Drazuam/microquad/hw/quad_v0/pcb_pdf/minidrone-B_Cu.pdf

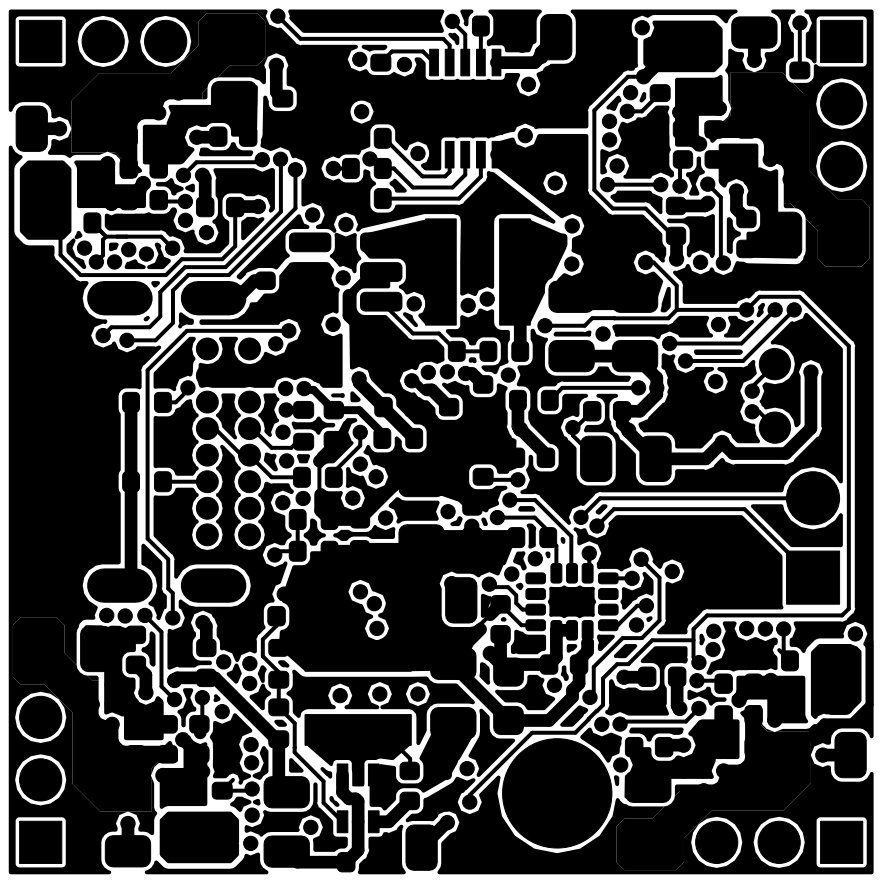
[picture p6: page 1]
