Drazuam/microquad/hw/quad_v0/pcb_pdf/minidrone-B_Mask.pdf

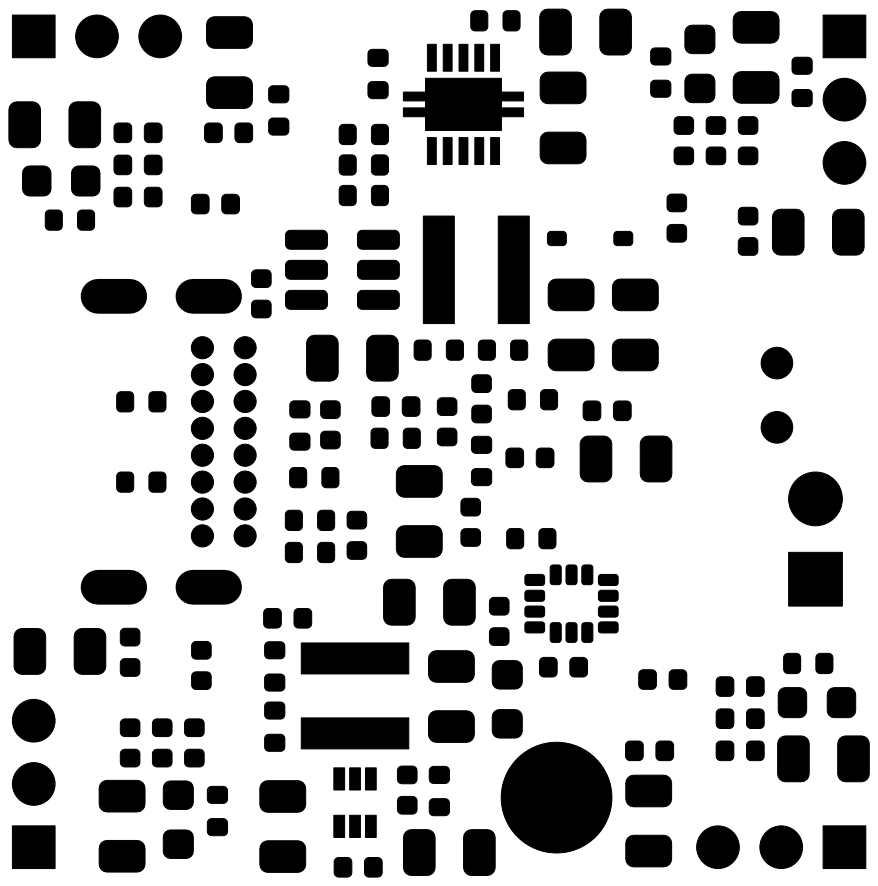
[picture p7: page 1]
