Drazuam/microquad/hw/quad_v0/pcb_pdf/minidrone-B_Paste.pdf

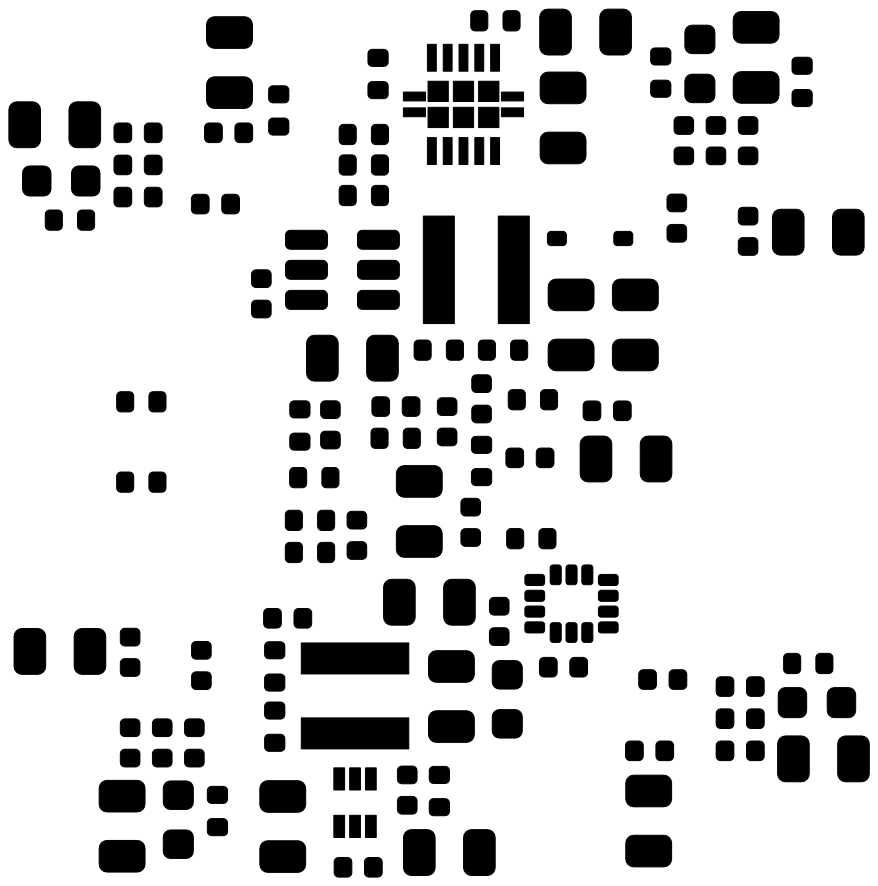
[picture p8: page 1]
