Drazuam/microquad/hw/quad_v0/pcb_pdf/minidrone-B_Silkscreen.pdf

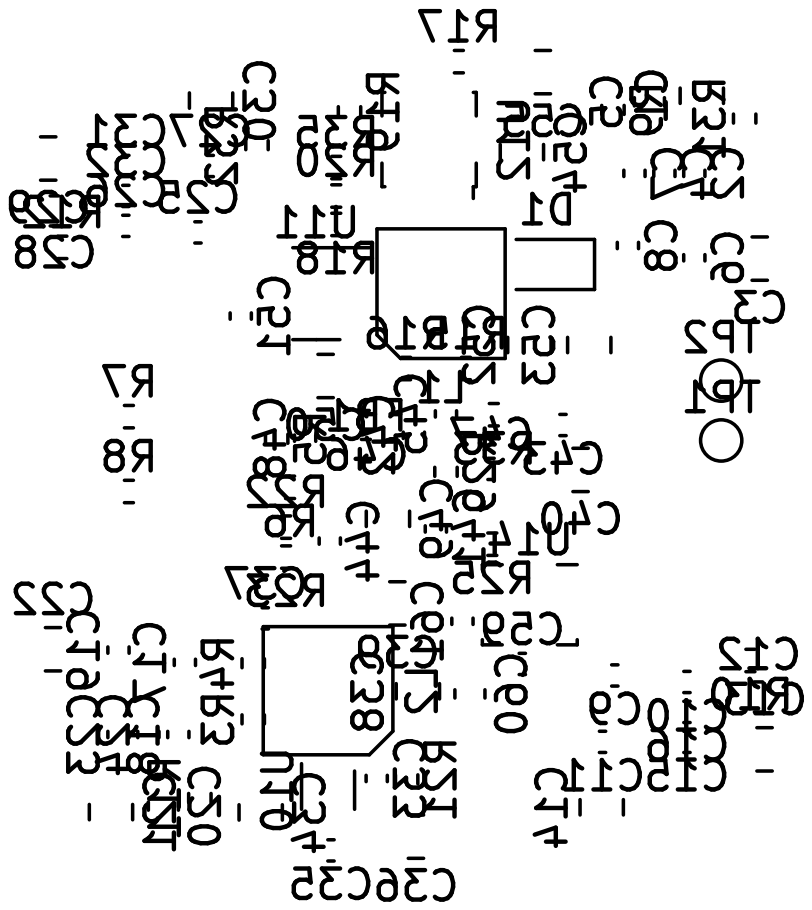
[picture p9: page 1]
