Drazuam/microquad/hw/quad_v0/pcb_pdf/minidrone-F_Cu.pdf

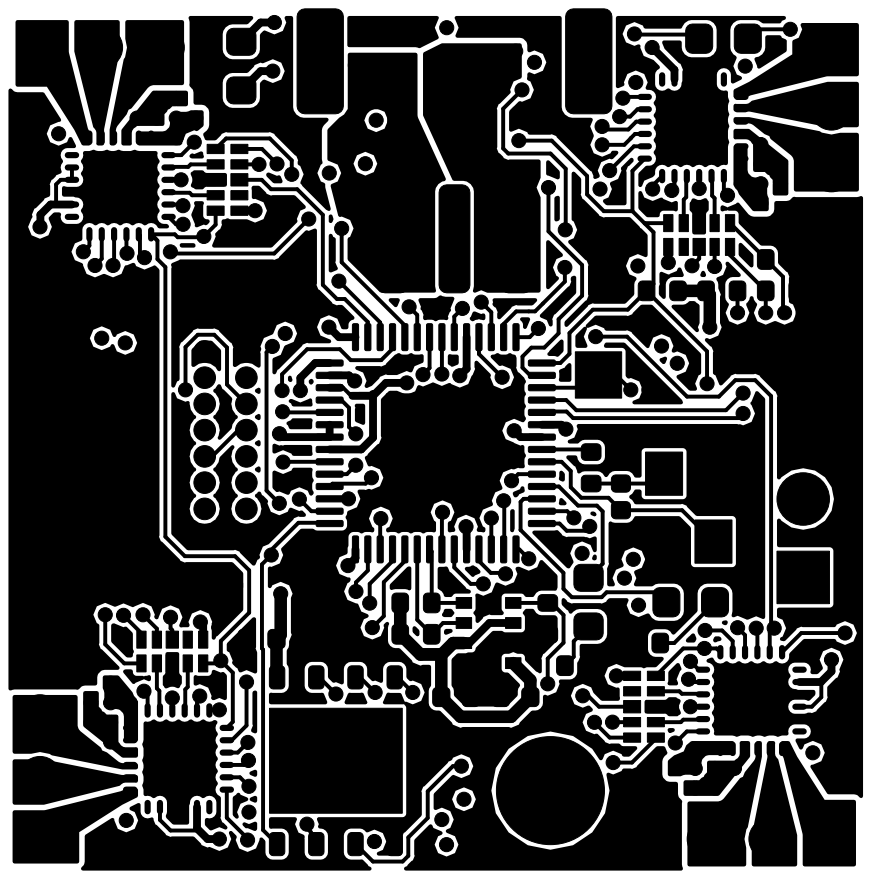
[picture p10: page 1]
