Drazuam/microquad/hw/quad_v0/pcb_pdf/minidrone-F_Mask.pdf

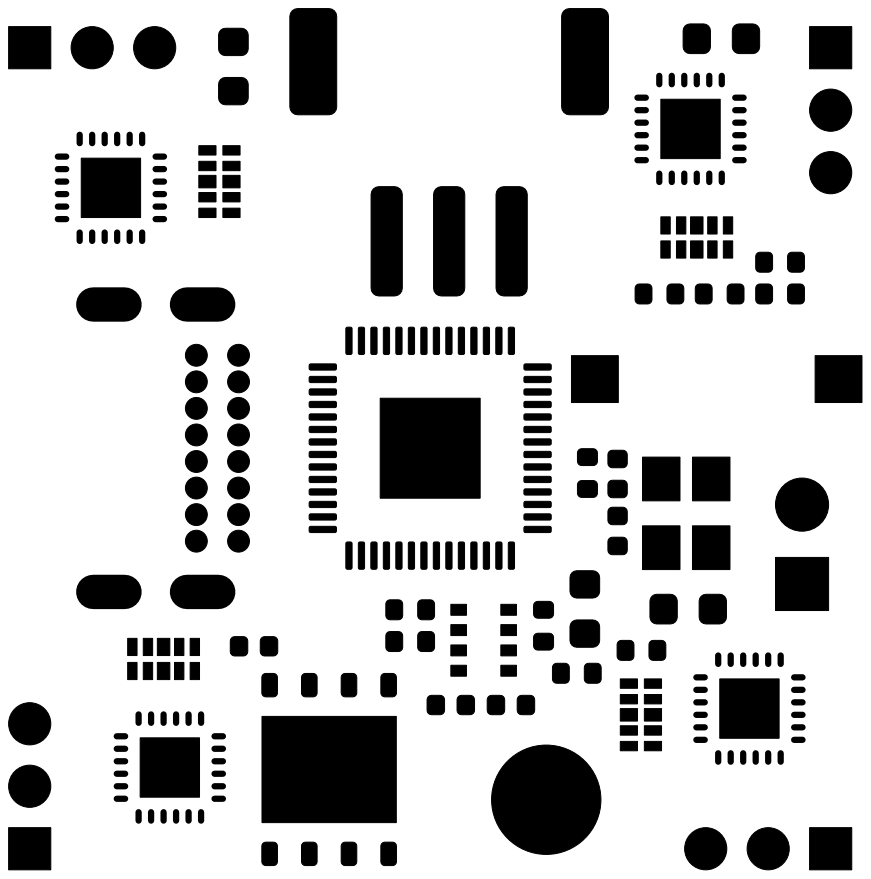
[picture p11: page 1]
