Drazuam/microquad/hw/quad_v0/pcb_pdf/minidrone-F_Paste.pdf

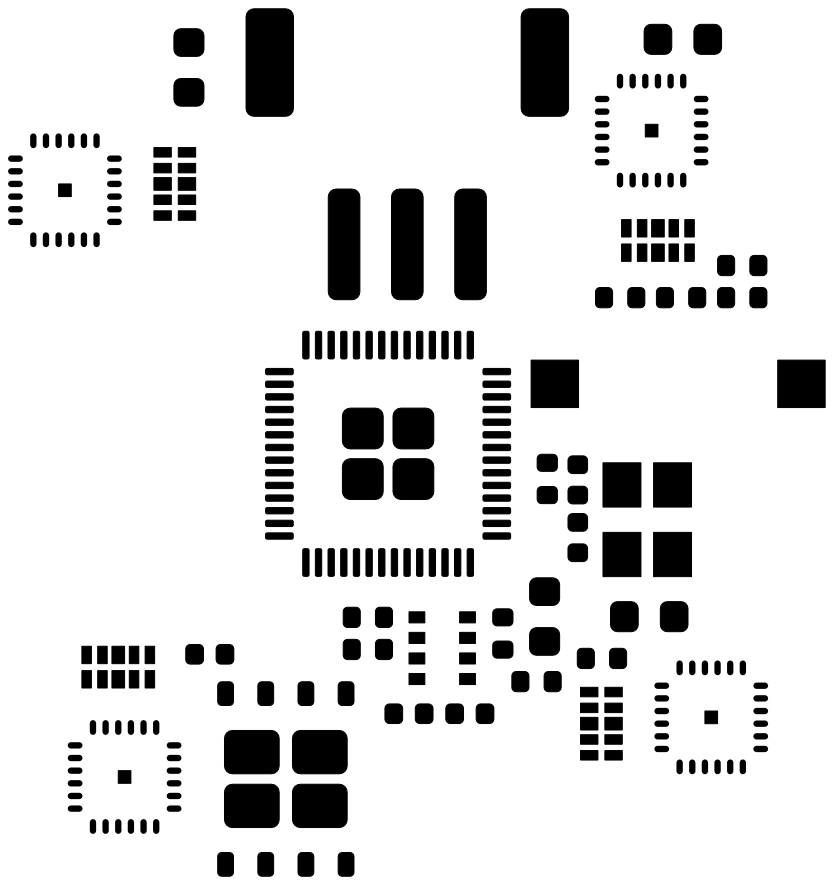
[picture p12: page 1]
