Drazuam/microquad/hw/quad_v0/pcb_pdf/minidrone-F_Silkscreen.pdf

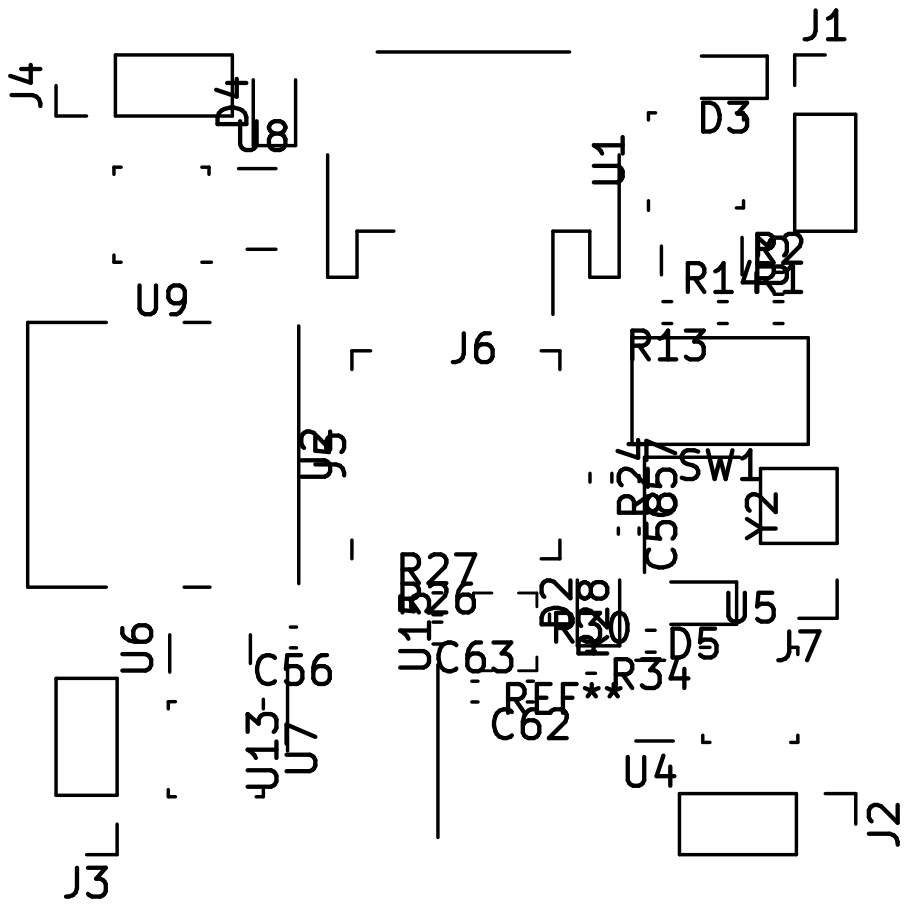
[picture p13: page 1]
