Drazuam/microquad/hw/quad_v0/pcb_pdf/minidrone-In1_Cu.pdf

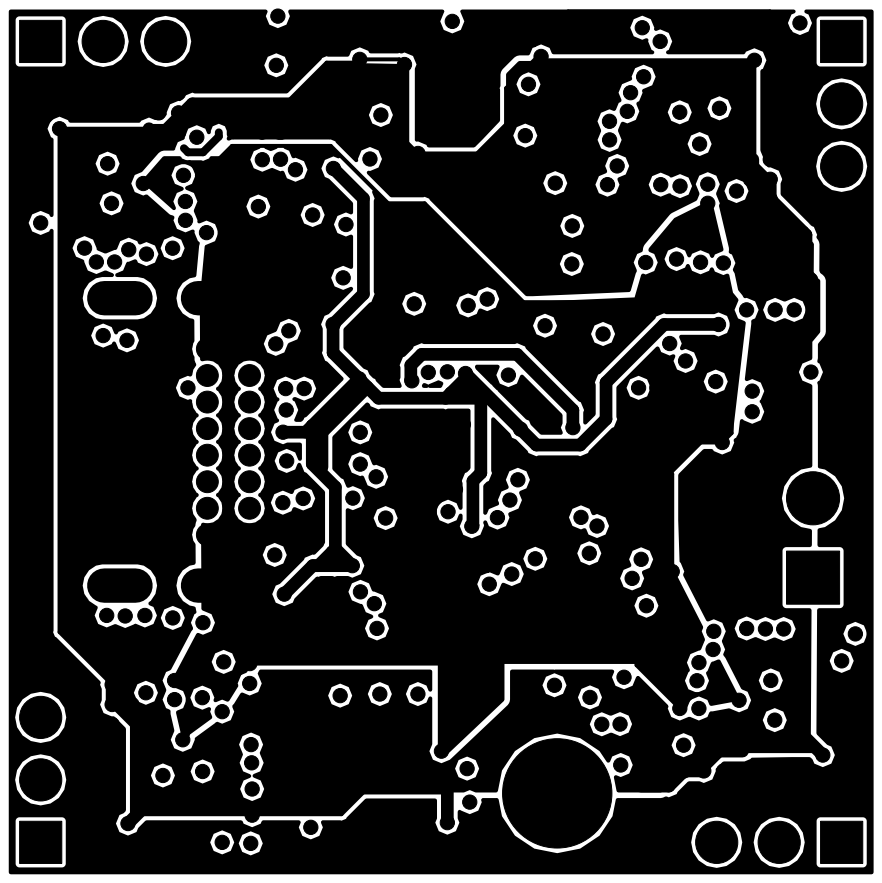
[picture p14: page 1]
