Drazuam/microquad/hw/quad_v0/pcb_pdf/minidrone-In2_Cu.pdf

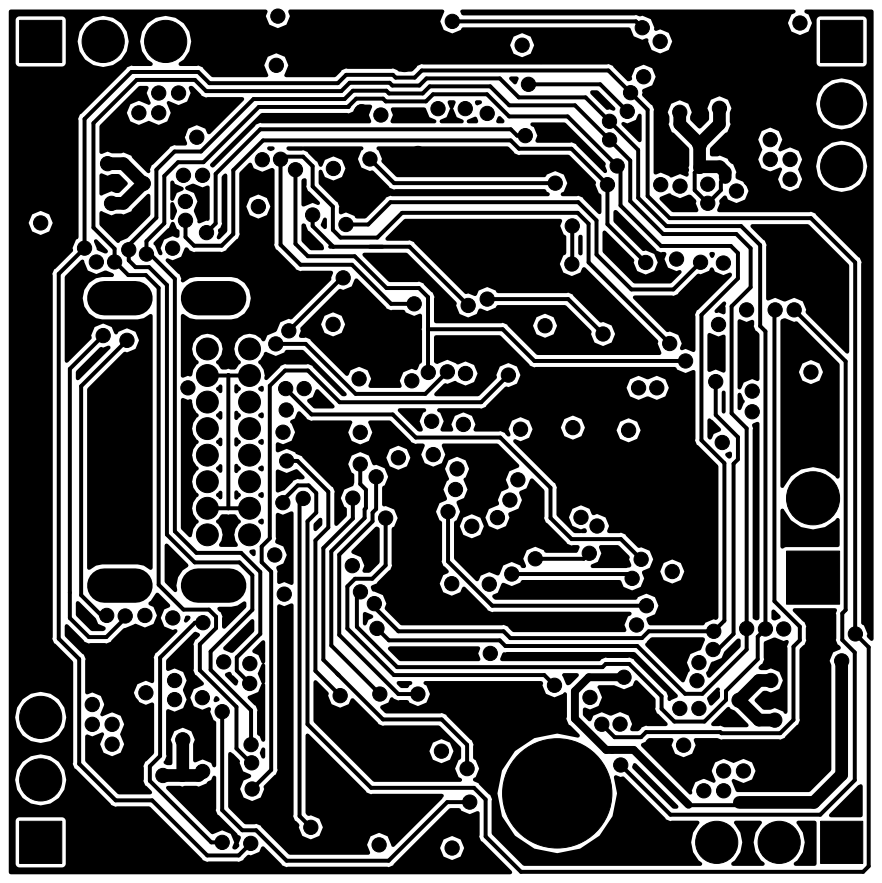
[picture p15: page 1]
