Drazuam/microquad/hw/quad_v0/kicad/minidrone.kicad_pcb

## KiCad design hw/quad_v0/kicad/minidrone.kicad_pcb (2023-07-24)

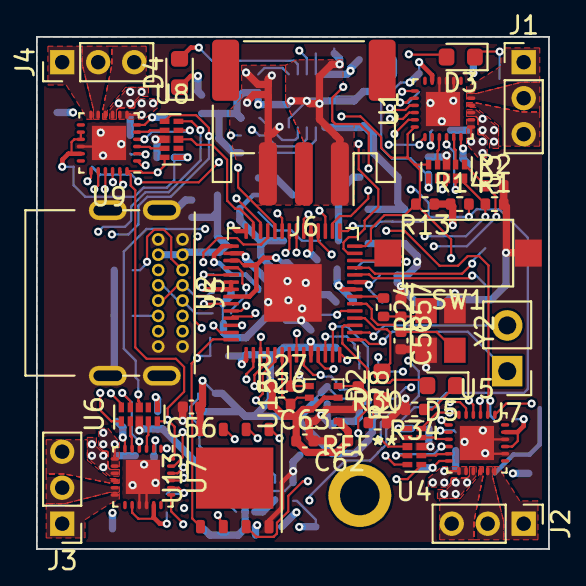
[picture p16: board minidrone.kicad_pcb from above]

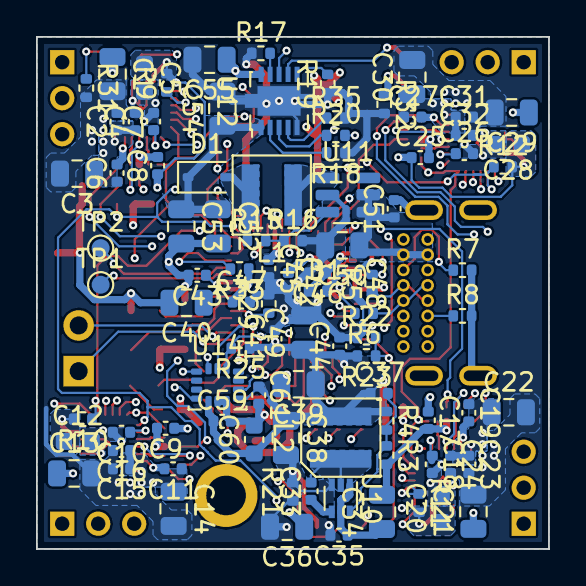
[picture p17: board minidrone.kicad_pcb from below]

Board: 4 copper layers, 28.4 x 28.4 mm, 132 parts (93 on the bottom side), 109 nets.

Parts:
C1, C3, C13, C14, C21, C22, C29, C30, C34, C36, C38, C39, C40, C49, C50, C52, C53, C54, C55: 10uF; C_0805_2012Metric
C2, C4, C6, C7, C8, C9, C10, C11, C15, C16, C17, C18, C19, C23, C24, C25, C26, C27, C31, C32, C33, C35, C41, C42, C43, C44, C45, C46, C47, C48, C51, C56, C59, C61, C62, C63: 0.1uF; C_0402_1005Metric
C5, C12, C20, C28, C60: 4.7uF; C_0603_1608Metric
C37: DNP; C_0402_1005Metric
C57, C58: 30pF; C_0402_1005Metric
D1: 20V, 1A; D_SOD-323
D2, D3, D4, D5: GREEN; LED_0603_1608Metric
FB1: 30 Ohm; R_0402_1005Metric
J1, J2, J3, J4: Motor; PinHeader_1x03_P2.00mm_Vertical
J5: USB_C; USB_C_Receptacle_CVILUX
J6: Battery; JST_PH_S3B-PH-SM4-TB_1x03-1MP_P2.00mm_Horizontal
J7: Conn_01x02_Pin; PinHeader_1x02_P2.54mm_Vertical
L1, L2: 4.7uH; EXLA1V04
R1, R2, R3, R9, R10, R11, R12, R13, R14, R16, R20, R25, R26, R27, R28, R30, R31, R32, R33, R34, R35: 10K; R_0402_1005Metric
R4: 31K; R_0402_1005Metric
R5, R6: 27.4; R_0402_1005Metric
R7, R8: 5.1K; R_0402_1005Metric
R15: 115K; R_0402_1005Metric
R17: 3.6K; R_0402_1005Metric
R18: 375; R_0402_1005Metric
R19: 100K; R_0402_1005Metric
R21: 0; R_0402_1005Metric
R22, R23, R29: DNP; R_0402_1005Metric
R24: 1K; R_0402_1005Metric
SW1: SW_DIP_x01; SW_SPST_CK_RS282G05A3
TP1, TP2: TestPoint; TestPoint_Pad_D1.0mm
U1, U5, U7, U9: DRV8311P; QFN-24_EP_3x3_Pitch0.4mm
U2: RP2040; QFN-56-1EP_7x7mm_P0.4mm_EP3.2x3.2mm
U3, U4, U6, U8: USON-10_2.5x1.0mm_P0.5mm
U10: TPS563207S; SOT-563
U11: TLV61048; SOT-23-6
U12: BQ25171-Q1; VSON-10-1EP_3x3mm_P0.5mm_EP1.65x2.4mm
U13: 128MBIT; WSON-8-1EP_6x5mm_P1.27mm_EP3.4x4.3mm
U14: ICM-42670-P; LGA-14_3x2.5mm_P0.5mm_LayoutBorder3x4y
U15: DPS310XTSA1; Bosch_LGA-8_2x2.5mm_P0.65mm_ClockwisePinNumbering
Y2: 12MHz; Crystal_SMD_Abracon_ABM8AIG-4Pin_3.2x2.5mm

Connections:
+1V1: C40.1, C42.1, C43.1, U2.23 (DVDD), U2.45 (VREG_VOUT), U2.50 (DVDD)
+BATT: C1.1, C2.1, C3.1, C4.1, C6.1, C11.1, C13.1, C14.1, C15.1, C16.1, C19.1, C21.1, C22.1, C23.1, C24.1, C27.1, C29.1, C30.1, C31.1, C32.1, C34.1, C35.1, C36.1, C55.1, J6.3, U1.7 (VIN_AVDD), U1.8 (VM), U5.7 (VIN_AVDD), U5.8 (VM), U7.7 (VIN_AVDD), U7.8 (VM), U9.7 (VIN_AVDD), U9.8 (VM), U10.1 (VIN), U10.5 (EN), U12.10 (OUT)
/BARO_INT: R28.1, U2.3 (GPIO1), U15.5 (SDO/INT)
/BARO_SCL: R27.2, U2.7 (GPIO5), U15.4 (SCK/SCL)
/BARO_SDA: R26.2, U2.6 (GPIO4), U15.3 (SDI/SDA)
/CE_N: R20.1, U2.27 (GPIO16), U12.3 (CE_N)
/FAULT_N: R14.2, U1.1 (FAULT_N), U2.29 (GPIO18), U5.1 (FAULT_N), U7.1 (FAULT_N), U9.1 (FAULT_N)
/IMU_CS_N: R25.2, U2.12 (GPIO9), U14.12 (CS)
/IMU_INT1: U2.8 (GPIO6), U14.4 (INT1)
/IMU_INT2: U2.9 (GPIO7), U14.9 (INT2)
/IMU_SCLK: U2.13 (GPIO10), U14.13 (SCLK)
/IMU_SDI: U2.14 (GPIO11), U14.14 (SDI)
/IMU_SDO: U2.11 (GPIO8), U14.1 (SDO)
/MC1_CS_N: R9.1, U1.20 (SCS_N), U2.30 (GPIO19)
/MC1_SENSE: U2.38 (GPIO26_ADC0), U3.8 (D)
/MC2_CS_N: R10.1, U2.31 (GPIO20), U5.20 (SCS_N)
/MC2_SENSE: U2.39 (GPIO27_ADC1), U4.8 (D)
/MC3_CS_N: R11.1, U2.32 (GPIO21), U7.20 (SCS_N)
/MC3_SENSE: U2.40 (GPIO28_ADC2), U6.8 (D)
/MC4_CS_N: R12.1, U2.34 (GPIO22), U9.20 (SCS_N)
/MC4_SENSE: U2.41 (GPIO29_ADC3), U8.8 (D)
/MC_SCLK: U1.23 (SCLK), U2.4 (GPIO2), U5.23 (SCLK), U7.23 (SCLK), U9.23 (SCLK)
/MC_SDI: U1.22 (SDI), U2.5 (GPIO3), U5.22 (SDI), U7.22 (SDI), U9.22 (SDI)
/MC_SDO: U1.21 (SDO), U2.2 (GPIO0), U5.21 (SDO), U7.21 (SDO), U9.21 (SDO)
/Motor Controller 1/AVDD: C5.1, C8.1, R9.2, U1.17 (AVDD), U3.6 (VDD)
/Motor Controller 2/AVDD: C9.1, C12.1, R10.2, U4.6 (VDD), U5.15 (AD0), U5.17 (AVDD)
/Motor Controller 3/AVDD: C17.1, C20.1, R11.2, U6.6 (VDD), U7.14 (AD1), U7.17 (AVDD)
/Motor Controller 4/AVDD: C25.1, C28.1, R12.2, U8.6 (VDD), U9.14 (AD1), U9.15 (AD0), U9.17 (AVDD)
/PWM_SYNC: U1.19 (PWM_SYNC), U2.35 (GPIO23), U5.19 (PWM_SYNC), U7.19 (PWM_SYNC), U9.19 (PWM_SYNC)
/QSPI_CS: R22.2, R23.1, U2.56 (QSPI_SS), U13.1 (CS_N)
/SENSE_SEL_0: R2.1, U2.36 (GPIO24), U3.1 (A0), U4.1 (A0), U6.1 (A0), U8.1 (A0)
/SENSE_SEL_1: R1.1, U2.37 (GPIO25), U3.10 (A1), U4.10 (A1), U6.10 (A1), U8.10 (A1)
/SLEEP_N: R13.2, U1.24 (SLEEP_N), U2.28 (GPIO17), U3.5 (EN), U4.5 (EN), U5.24 (SLEEP_N), U6.5 (EN), U7.24 (SLEEP_N), U8.5 (EN), U9.24 (SLEEP_N)
/UART0_RX: J7.2, U2.16 (GPIO13)
/UART0_TX: J7.1, U2.15 (GPIO12)
Earth: C1.2, C2.2, C3.2, C4.2, C13.2, C14.2, C15.2, C16.2, C21.2, C22.2, C23.2, C24.2, C29.2, C30.2, C31.2, C32.2, C35.2, C36.2, C54.2, C55.2, J6.1, R17.1, R18.1, R19.1, R21.1, R31.2, R32.2, R35.2, U1.9 (PGND), U5.9 (PGND), U7.9 (PGND), U9.9 (PGND), U12.5 (GND), U12.11 (EP)
GNDA: C5.2, C7.2, C8.2, C9.2, C10.2, C12.2, C17.2, C18.2, C20.2, C25.2, C26.2, C28.2, C34.2, C38.2, C39.2, C40.2, C41.2, C42.2, C43.2, C44.2, C45.2, C46.2, C47.2, C48.2, C49.2, C50.2, C51.2, C52.2, C53.2, C56.2, C57.1, C58.2, C59.2, C60.2, C61.2, C62.2, C63.2, J5.A1 (GND), J5.A12 (GND), J5.B1 (GND), J5.B12 (GND), J5.S1 (SHIELD), R1.2, R2.2, R3.2, R7.2, R8.2, R16.2, R21.2, R22.1, R28.2, R29.2, R30.2, R34.2, SW1.1, U1.14 (AD1), U1.15 (AD0), U1.16 (AGND), U1.25 (EP), U2.57 (GND), U3.3 (GND), U4.3 (GND), U5.14 (AD1), U5.16 (AGND), U5.25 (EP), U6.3 (GND), U7.15 (AD0), U7.16 (AGND), U7.25 (EP), U8.3 (GND), U9.16 (AGND), U9.25 (EP), U10.3 (GND), U11.2 (GND), U13.4 (GND), U14.6 (GND), U14.7 (FSYNC), U15.1 (GND), U15.7 (GND), Y2.2, Y2.4
unnamed: C57.2, R24.2, Y2.1
unnamed: D1.2 (A), L1.2, R15.1
unnamed: C52.1, C53.1, C54.1, D1.1 (K), U12.1 (IN)
unnamed: D2.2 (A), U2.18 (GPIO15)
unnamed: D2.1 (K), R30.1
unnamed: D3.2 (A), U12.8 (STAT2)
unnamed: D3.1 (K), R31.1
unnamed: D4.2 (A), U12.7 (STAT1)
unnamed: D4.1 (K), R32.1
unnamed: D5.2 (A), U2.17 (GPIO14)
unnamed: D5.1 (K), R34.1
unnamed: J1.1, U1.12 (OUTC)
unnamed: J1.2, U1.11 (OUTB)
unnamed: J1.3, U1.10 (OUTA)
unnamed: J2.1, U5.12 (OUTC)
unnamed: J2.2, U5.11 (OUTB)
unnamed: J2.3, U5.10 (OUTA)
unnamed: J3.1, U7.12 (OUTC)
unnamed: J3.2, U7.11 (OUTB)
unnamed: J3.3, U7.10 (OUTA)
unnamed: J4.1, U9.12 (OUTC)
unnamed: J4.2, U9.11 (OUTB)
unnamed: J4.3, U9.10 (OUTA)
unnamed: J5.A5 (CC1), R7.1
unnamed: J5.B5 (CC2), R8.1
unnamed: J5.A6 (D+), J5.B6 (D+), R5.1
unnamed: J5.A7 (D-), J5.B7 (D-), R6.1
unnamed: C6.2, U1.6 (CP)
unnamed: C7.1, U1.2 (CSAREF)
unnamed: U1.5 (SOA), U3.2 (S1)
unnamed: U1.4 (SOB), U3.9 (S2)
unnamed: U1.3 (SOC), U3.4 (S3)
unnamed: C48.1, FB1.2, U2.43 (ADC_AVDD)
unnamed: R33.2, SW1.2, U2.26 (RUN)
unnamed: TP1.1, U2.24 (SWCLK)
unnamed: TP2.1, U2.25 (SWD)
unnamed: R29.1, U2.19 (TESTEN)
unnamed: R6.2, U2.46 (USB_DM)
unnamed: R5.2, U2.47 (USB_DP)
unnamed: C58.1, U2.20 (XIN), Y2.3
unnamed: R24.1, U2.21 (XOUT)
unnamed: U4.2 (S1), U5.5 (SOA)
unnamed: U4.9 (S2), U5.4 (SOB)
unnamed: U4.4 (S3), U5.3 (SOC)
unnamed: C11.2, U5.6 (CP)
unnamed: C10.1, U5.2 (CSAREF)
unnamed: U6.2 (S1), U7.5 (SOA)
unnamed: U6.9 (S2), U7.4 (SOB)
unnamed: U6.4 (S3), U7.3 (SOC)
unnamed: C19.2, U7.6 (CP)
unnamed: C18.1, U7.2 (CSAREF)
unnamed: U8.2 (S1), U9.5 (SOA)
unnamed: U8.9 (S2), U9.4 (SOB)
unnamed: U8.4 (S3), U9.3 (SOC)
unnamed: C27.2, U9.6 (CP)
unnamed: C26.1, U9.2 (CSAREF)
unnamed: C33.1, U10.4 (BST)
unnamed: C37.2, R3.1, R4.2, U10.6 (FB)
unnamed: C33.2, L2.1, U10.2 (SW)
unnamed: R15.2, R16.1, U11.3 (FB)
unnamed: L1.1, U11.1 (SW)
unnamed: R19.2, U12.6 (CHM_TMR)
unnamed: R18.2, U12.2 (ISET)
unnamed: R35.1, U12.4 (TS)
unnamed: R17.2, U12.9 (VSET)
unnamed: U2.52 (QSPI_SCLK), U13.6 (CLK)
unnamed: U2.53 (QSPI_SD0), U13.5 (IO0)
unnamed: U2.55 (QSPI_SD1), U13.2 (IO1)
unnamed: U2.54 (QSPI_SD2), U13.3 (IO2)
unnamed: U2.51 (QSPI_SD3), U13.7 (IO3)
VBUS: C50.1, C51.1, J5.A4 (VBUS), J5.A9 (VBUS), J5.B4 (VBUS), J5.B9 (VBUS), U11.4 (EN), U11.5 (VIN)
VCC: C37.1, C38.1, C39.1, C41.1, C44.1, C45.1, C46.1, C47.1, C49.1, C56.1, C59.1, C60.1, C61.1, C62.1, C63.1, FB1.1, L2.2, R4.1, R13.1, R14.1, R20.2, R23.2, R25.1, R26.1, R27.1, R33.1, U2.1 (IOVDD), U2.10 (IOVDD), U2.22 (IOVDD), U2.33 (IOVDD), U2.42 (IOVDD), U2.44 (VREG_IN), U2.48 (USB_VDD), U2.49 (IOVDD), U13.8 (VCC), U14.5 (VDDIO), U14.8 (VDD), U15.2 (CSB/SEL), U15.6 (VDDIO), U15.8 (VDD)
