Drazuam/microquad/(commit log)

2023-07-24 initial project share. v0 test bed schematic and layout ready
    [minidrone-B_Cu.gbr, minidrone-B_Mask.gbr, minidrone-B_Paste.gbr, minidrone-B_Silkscreen.gbr, minidrone-Edge_Cuts.gbr, minidrone-F_Cu.gbr, minidrone-F_Mask.gbr, minidrone-F_Paste.gbr]
2023-07-28 adds ros2 node structure for a thrust publisher
